duvohuu/Mechatronics_System_Design_Project/Report/chapter7.tex

\chapter{THIẾT KẾ GIẢI THUẬT ĐIỀU KHIỂN}
     \section{Lưu đồ giải thuật chung cho robot}
          \begin{figure}[H]
               \centering
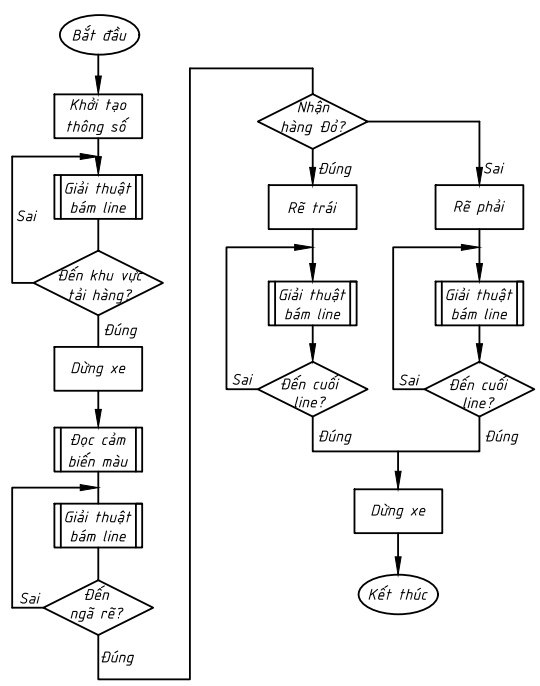
[picture p8: Report/pictures/chapter7/flow1.png]
               
               \caption{Lưu đồ giải thuật chung}
               \label{flow1}
          \end{figure}
     \section{Thiết lập sa bàn}
          \hspace*{0.6cm}Hình ảnh sa bàn đầu bài
          \begin{figure}[H]
               \centering
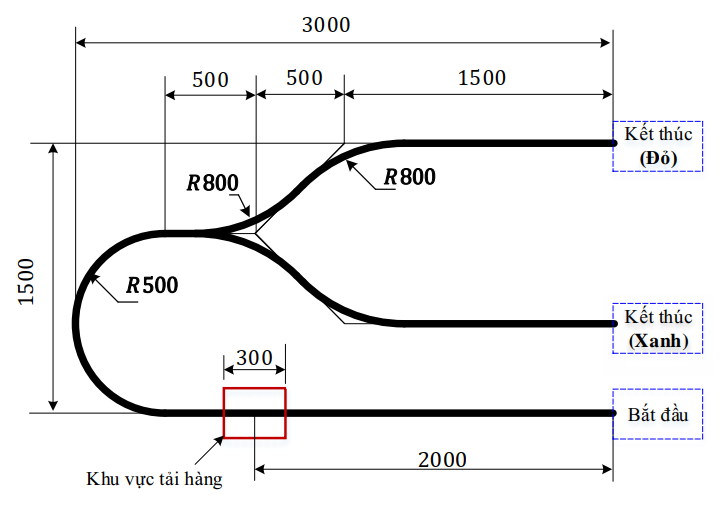
[picture p9: Report/pictures/chapter7/saban.png]
               
               \caption{Sa bàn}
               \label{race}
          \end{figure}
          Phân đoạn sa bàn
          \begin{figure}[H]
               \centering
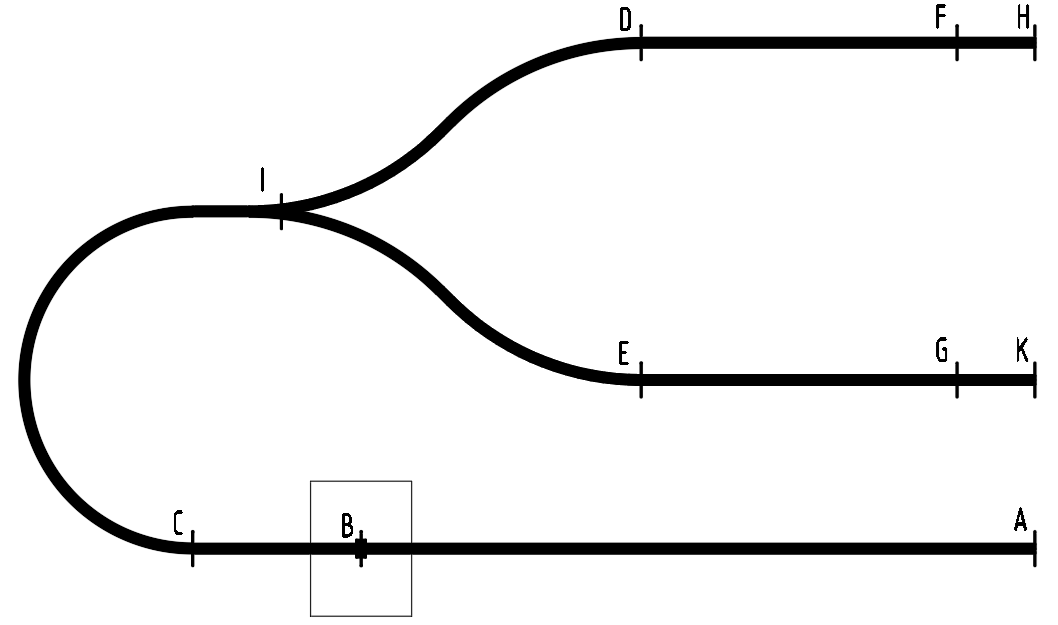
[picture p10: Report/pictures/chapter7/cut_saban.png]
               
               \caption{Phân đoạn sa bàn}
               \label{cut_race}
          \end{figure}
          Trong đó:
          \begin{itemize}
               \item $A$: điểm bắt đầu, cần đặt xe sao cho xe bắt được line đen.
               \item $B$: vị trí xe dừng để nhận hàng, được đánh dấu bằng một vạch line đen cắt
               ngang với chiều dài 50mm và chiều rộng 26mm. Với kích thước như đầu bài, vạch tải
               hàng được nhận biết khi có 3 cảm biến phát hiện được giá trị vượt ngưỡng đã đặt trước.
               \item $C$: điểm bắt đầu giảm tốc để vào cua, xe chạy tốc độ chậm hơn khi ở trên đoạn $C-D$ hoặc $C-E$.
               \item $I$: điểm rẽ hướng, Nhận biết bằng điều kiện số cảm biến nhận line đen và phân biệt với vị trí $B$ nhờ điều kiện có tải hay không.
               \item $D$ và $E$: 2 điểm kết thúc đoạn xe chạy với tốc độ chậm để đảm bảo vào cua tương ứng với 2 quỹ đạo. Sau đó xe tăng tốc chạy với tốc độ ban đầu trên các đoạn $D-F$ hoặc $E-G$.
               \item $F$ và $G$: 2 điểm xe bắt đầu giảm tốc để đảm bảo dừng lại ở vị trí cuối line, đoạn $F-H$ và $G-K$ xe chạy chậm dần đều.
               \item $H$: điểm kết thúc nếu nhận hàng màu đỏ, nhận biết điểm kết thúc khi xe đi hết đường line đen.
               \item $K$: điểm kết thúc nếu nhận hàng màu xanh, nhận biết điểm kết thúc khi xe đi hết đường line đen
          \end{itemize}
     \section{Giải thuật}
          \subsection{Giải thuật bám line}
               \hspace*{0.6cm}Giá trị analog đọc về từ 5 cảm biến dò line được tính toán bằng giải thuật nội suy
               trung bình trọng số, đưa ra được sai số $e_2$ là sai số giữa tâm cảm biến và tâm đường
               line. Đưa sai số $e_2$ là đầu vào bộ điều khiển PID hệ thống để tính toán ra vận tốc
               bánh trái và vận tốc bánh phải của động cơ. Từ vận tốc hai bánh có được đưa vào bộ
               điều khiển PID của 2 động cơ để tính toán cấp xung cho 2 động cơ tương ứng.
          \subsection{Giải thuật hoàn thành đầu bài}
               \hspace*{0.6cm}Giai đoạn 1, robot đi từ điểm bắt đầu $A$ đến điểm tải hàng $B$ bằng giải thuật bám line. Khi gặp vạch tải hàng, 3 trên 5 cảm biến dò line sẽ có giá trị vượt ngưỡng (cho thấy cả 3 cảm biến đều đã nhìn thấy line đen)
               xét cùng với trạng thái của cờ \textit{empty} (thể hiện tình trạng có tải của xe), khi đó xe dừng và cờ báo xe dừng chờ nhận tải hàng được kích hoạt.\\
               \hspace*{0.6cm}Giai đoạn 2, giai đoạn tải hàng. Khi đặt gói hàng lên xe, thì cảm biến màu sẽ đọc
               tín hiệu màu của gói hàng. Khi cảm biến đã xác nhận được màu của gói hàng là Xanh hoặc
               Đỏ, xe đợi 5s sau đó tiếp tục chạy.\\
               \hspace*{0.6cm}Giai đoạn 3, robot đi từ điểm tải hàng $B$ đến điểm rẽ hướng $I$. Bằng cách đếm xung encoder, robot nhận biết được khúc vào cua bán kính $R500$ để giảm tốc độ xuống để vào line (điểm $C$), robot sẽ đi qua đoạn cua $R500$ sau đó đi thẳng đến điểm $I$. Xe nhận biết
               được đoạn rẽ bằng số lượng cảm biến, khi 3 trên 5 cảm biến có tín hiệu và cờ báo hiệu rẽ được kích hoạt,
               xe nhận biết được sẽ rẽ sang bên đường tương ứng với màu sắc khi xác nhận tại điểm $B$.\\
               \hspace*{0.6cm}Giai đoạn 4, robot đi từ điểm rẽ hướng $I$ đến điểm kết thúc $H$ tương ứng màu Đỏ
               hoặc $K$ tương ứng màu Xanh. Trong đó trên các đoạn cua bán kính $R800$ $I-D$ và $I-E$ xe vẫn chạy với tốc độ khi vào cua $R500$. Đến điểm $D$ hoặc $E$ (vị trí các điểm xác định bằng cách đếm số xung encoder) xe bắt đầu tăng tốc trở lại vận tốc ban đầu. Đến các điểm $F$ hoặc $G$, xe bắt đầu giảm tốc để đảm bảo sai số dừng lại cuối line.
               \begin{figure}[H]
                    \centering
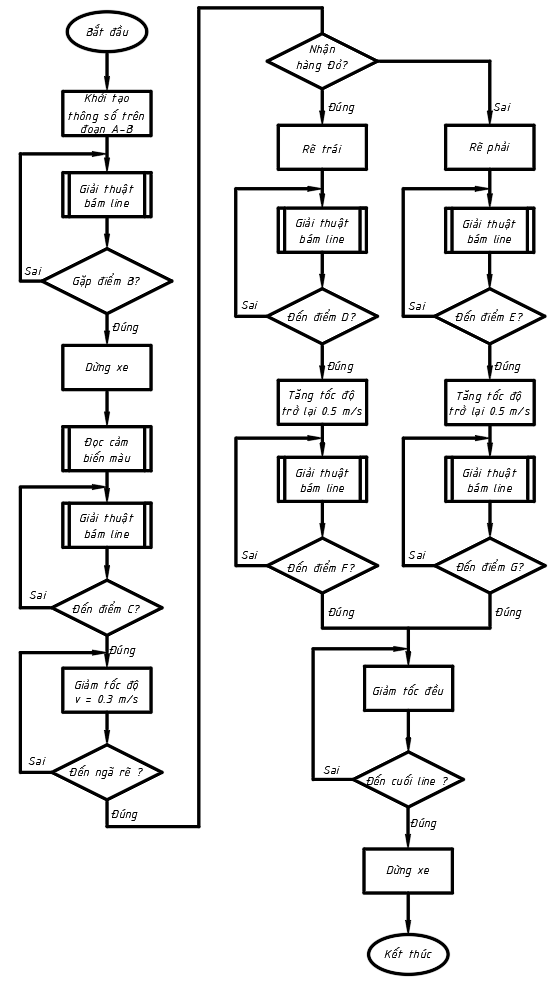
[picture p11: Report/pictures/chapter7/flow3.png]
                    
                    \caption{Lưu đồ giải thuật cụ thể trên từng đoạn sa bàn}
                    \label{flow2}
               \end{figure}
