duvohuu/Mechatronics_System_Design_Project/Report/titlepage.tex

\begin{titlepage}   
    \begin{center}
        \vspace*{-2cm} 
        \large
        \textbf{ĐẠI HỌC QUỐC GIA THÀNH PHỐ HỒ CHÍ MINH \\
        TRƯỜNG ĐẠI HỌC BÁCH KHOA\\
        KHOA CƠ KHÍ - BỘ MÔN CƠ ĐIỆN TỬ\\}
        \vspace{0.5cm}
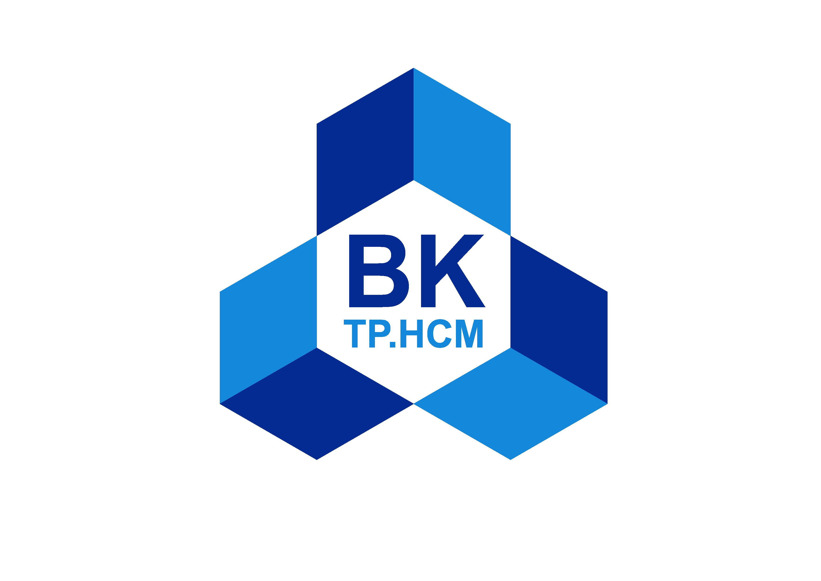
[picture p49: Report/pictures/hcmut.png]
         \\
        \rule{\linewidth}{0.5mm}\\
        \vspace{1cm}
        \large
        \textbf{ĐỒ ÁN CHUYÊN NGÀNH KỸ THUẬT CƠ ĐIỆN TỬ}\\                                                                                                                                                                                                                    
        \vspace*{0.5cm}
        \textbf{Đề số 2}\\                                                                                                                                                                                                                                                                                                                                                                                                                                             
        \vspace{0.25cm}
        \textbf{ROBOT PHÂN PHỐI HÀNG HÓA THEO MÀU SẮC}\\
        \vspace{0.5cm}
        \rule{\linewidth}{0.5mm}\\
        \vspace{0.6cm}
        \textbf{LỚP DT01 - HK 243} \\
        \vspace{0.8cm}
        \textbf{GVHD: ThS. Lương Thanh Nhật} \\[0.5cm]
        \vspace{0.5cm}
        SINH VIÊN THỰC HIỆN:\\[0.3cm]
        \begin{tabular}{|>{\centering\arraybackslash}m{1cm}|>{\centering\arraybackslash}m{7cm}|>{\centering\arraybackslash}m{5cm}|}
            \hline
            \textbf{STT} & \textbf{Họ và tên} & \textbf{MSSV} \\
            \hline
            1 & Võ Hữu Dư & 2210604 \\
            \hline
            2 & Đào Trọng Chân & 2210350 \\
            \hline
            3 & Nguyễn Trần Văn Tiên & 2210350 \\
            \hline
        \end{tabular}
    \end{center}
        
    \vfill
    \large
    \begin{center}
        TP.HCM, \today
    \end{center}
\end{titlepage}
