duvohuu/Mechatronics_System_Design_Project/Report/chapter8.tex

\chapter{MÔ PHỎNG VÀ THỰC NGHIỆM}
     \section{Mô phỏng}
          \subsection{Thông số mô phỏng robot}
               \hspace*{0.6cm}Thực hiện mô phỏng chuyển động của Robot sau khi tìm được hàm truyền của động cơ bằng cách nhúng hàm truyền động cơ thu được từ chương 5,
               bộ điều khiển tốc độ, cùng với bộ điều khiển vị trí bám line thu được từ chương 6 với các thông số như sau:
               \begin{table}[h]
                    \centering
                    \begin{tabular}{|l|c|}
                    \hline
                    \multicolumn{2}{|c|}{\textbf{Thông số hình học}} \\
                    \hline
                    Bán kính bánh xe, $r$ & 41 mm \\
                    \hline
                    Khoảng cách từ tâm dây cảm biến đến trục bánh dẫn động, $a$ & 72 mm \\
                    \hline
                    Khoảng cách dọc trục giữa tâm 2 bánh xe, $b$ & 220 mm \\
                    \hline
                    \multicolumn{2}{|c|}{\textbf{Thời gian}} \\
                    \hline
                    Thời gian lấy mẫu bộ điều khiển động cơ, $t_{\text{s}}$ & 0.01 s \\
                    \hline
                    Thời gian lấy mẫu bộ điều khiển bám line, $t_{\text{đk}}$ & 0.05 s \\
                    \hline
                    \multicolumn{2}{|c|}{\textbf{Bộ điều khiển PID}} \\
                    \hline
                    Vị trí bám line & $K_P = 0.078$; $K_D = 0.015$ \\
                    \hline
                    Động cơ phải & $K_P = 1.0852$; $K_I = 13.6563$ \\
                    \hline
                    Động cơ trái & $K_P = 1.0673$; $K_I = 13.948$ \\
                    \hline
                    \multicolumn{2}{|c|}{\textbf{Thông số động học}} \\
                    \hline
                    Vận tốc của robot, $v$ & 500 mm/s \\
                    \hline
                    Vận tốc của robot lúc vào cua, $v_{\text{r}}$ & 300 mm/s \\
                    \hline
                    Góc lệch ban đầu, $p$ & $\pi$ \\
                    \hline
                    \end{tabular}
                    \label{tab:robot_specifications}
                    \caption{Thông số đầu vào mô phỏng chuyển động của robot}
               \end{table}
          \subsection{Thực hiện mô phỏng}
               \hspace*{0.6cm}Mô phỏng bằng phần mềm MATLAB, bước đầu tiên là tạo sa bàn với các kích thước như trong đầu bài
               \begin{figure}[H]
                    \centering
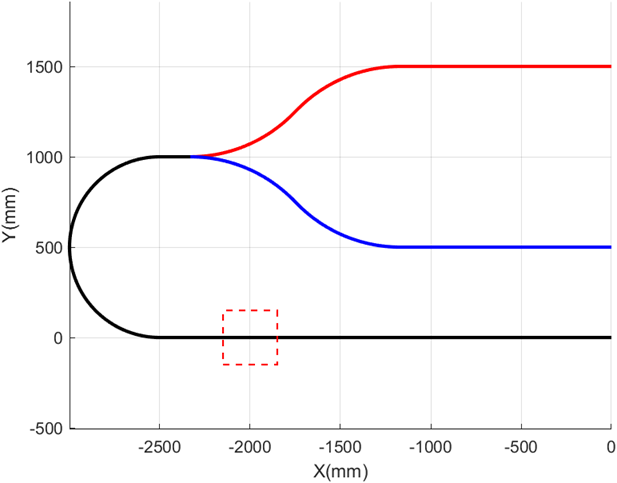
[picture p60: Report/pictures/chapter8/saban.png]
                    
                    \caption{Hình ảnh sa bàn}
                    \label{saban}
               \end{figure}
               \hspace*{0.6cm}Trong đó đường line màu đỏ và màu xanh lần lượt thể hiện nhánh rẽ khi xe nhận được khối hàng màu đỏ và xanh. Tại khu vực nhận hàng, mô phỏng quá trình đặt tải màu lên xe bằng 1 cửa sổ trong đó người dùng chọn màu sắc của khối hàng.
               \begin{figure}[H]
                    \centering
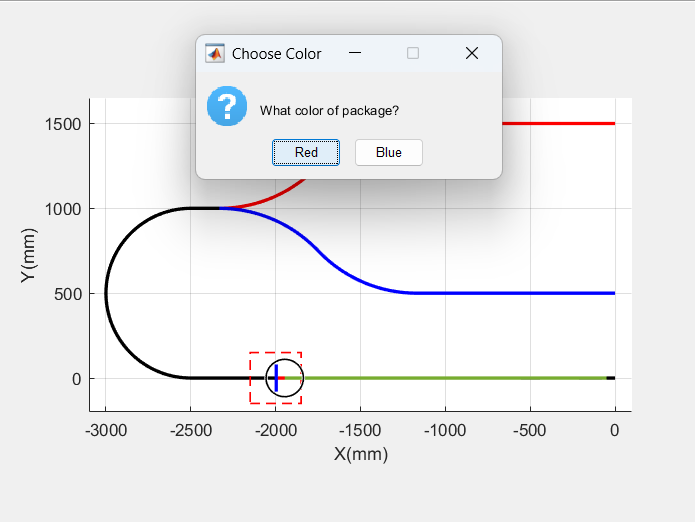
[picture p61: Report/pictures/chapter8/stop_for_package.png]
                    
                    \caption{Chọn màu sắc gói hàng}
                    \label{choose_color}
               \end{figure}
               \hspace*{0.6cm}Tùy thuộc vào màu sắc khối hàng mà sau khi gặp ngã rẽ, xe sẽ rẽ lên trên hoặc xuống dưới.
               \begin{figure}[H]
                    \centering
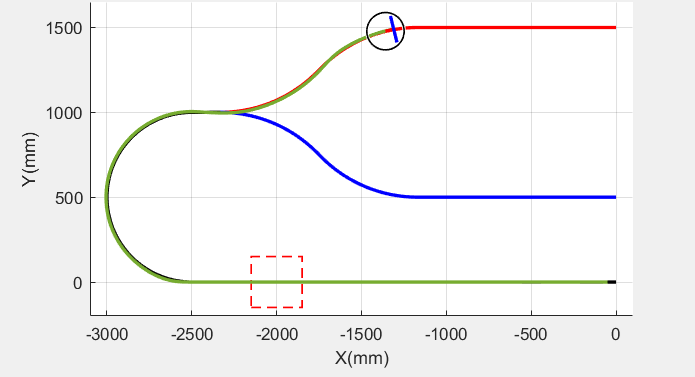
[picture p62: Report/pictures/chapter8/running.png]
                    
                    \caption{Hình ảnh xe chạy mô phỏng}
                    \label{running}
               \end{figure}     

          \subsection{Kết quả mô phỏng}
          Thực hiện mô phỏng xe chạy với vận tốc 0.3 m/s.
          \begin{itemize}
               \item \textbf{Khối hàng đỏ}
                    \begin{figure}[H]
                         \centering
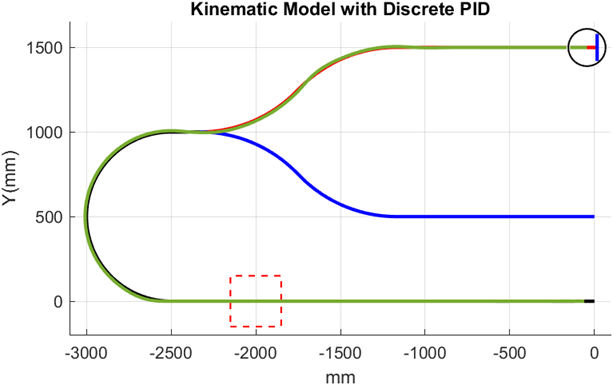
[picture p63: Report/pictures/chapter8/trajec_red.png]
                         
                         \caption{Quỹ đạo đi khi nhận khối hàng đỏ}
                         \label{tra_red}
                    \end{figure}
               \textbf{*Nhận xét:}
               \begin{itemize}
                    \item Từ hình \ref{err_red}, sai lệch trung bình giữa tâm cảm biến và tâm đường line trên toàn bộ đoạn đường là khoảng 4 mm.
                    \item Sai số bám line trên đoạn thẳng (< 6s) rất nhỏ, tuy nhiên khi xe bắt đầu vào cua thì sai số tăng dần, có 1 vị trí xe bị lệch ra khỏi line khoảng 50 mm (đối với trường hợp nhận khối hàng xanh, hình \ref{err_blue}), sau đó bám vào lại line và di chuyển tới cuối đường. 
               \end{itemize}
                    \begin{figure}[H]
                         \centering
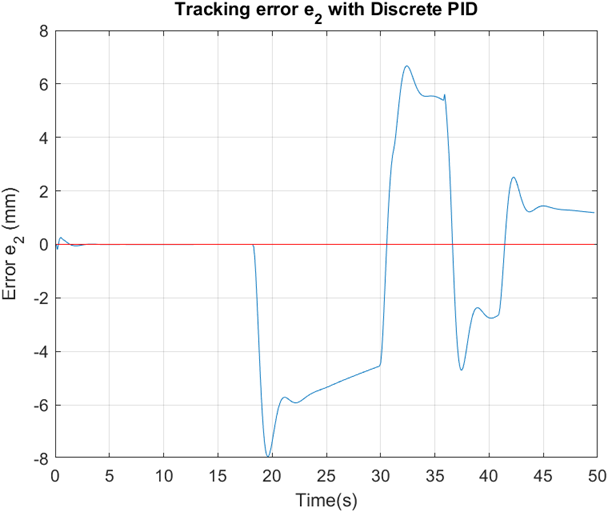
[picture p64: Report/pictures/chapter8/err_red.png]
                         
                         \caption{Sai số bám line e2 khi nhận khối hàng đỏ}
                         \label{err_red}
                    \end{figure}
               \item \textbf{Khối hàng xanh}
          \end{itemize}
               
          \subsection{Khối hàng xanh}
               \begin{figure}[H]
                    \centering
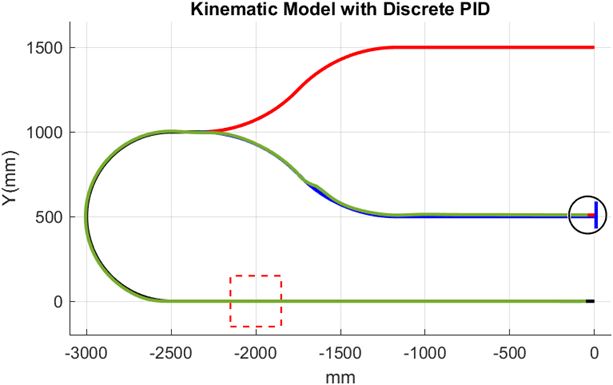
[picture p65: Report/pictures/chapter8/trajec_blue.png]
                    
                    \caption{Quỹ đạo đi khi nhận khối hàng xanh}
                    \label{tra_blue}
               \end{figure}
               \begin{figure}[H]
                    \centering
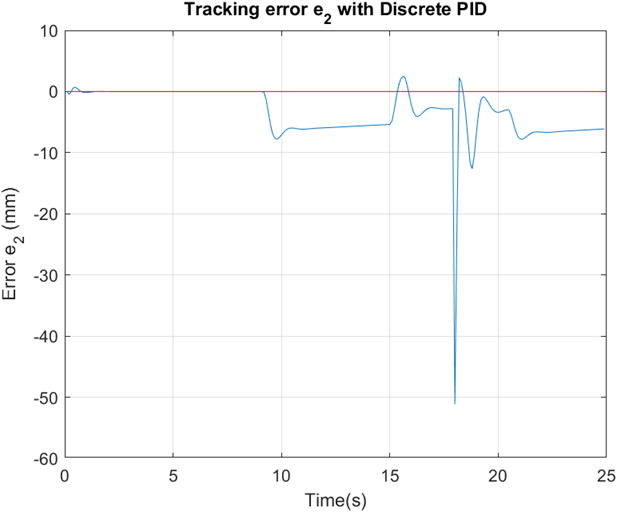
[picture p66: Report/pictures/chapter8/err_blue.png]
                    
                    \caption{Lỗi quỹ đạo e2 khi nhận khối hàng xanh}
                    \label{err_blue}
               \end{figure}
     \section{Thực nghiệm}
          \subsection{Thực nghiệm tổng quan}
               \begin{figure}[H]
                    \centering
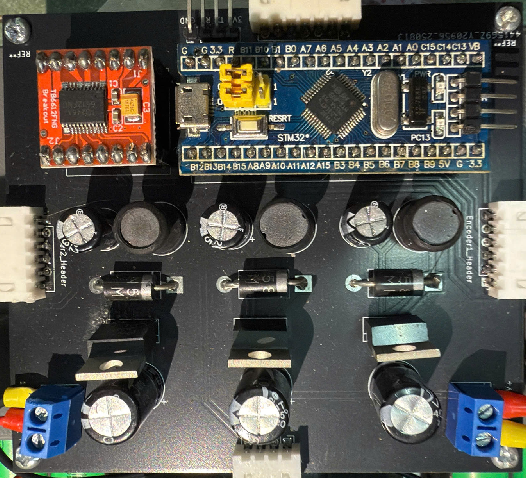
[picture p67: Report/pictures/chapter8/PCB.png]
                    
                    \caption{Mạch PCB điều khiển}
                    \label{PCB}
               \end{figure}
               \begin{figure}[H]
                    \centering
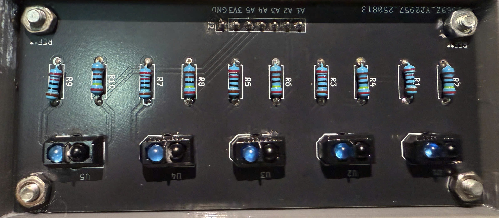
[picture p68: Report/pictures/chapter8/sensor.png]
                    
                    \caption{Mạch cảm biến dò line}
                    \label{line_sensor}
               \end{figure}
               \begin{figure}[H]
                    \centering
                    \begin{minipage}{0.42\textwidth}
                         \centering
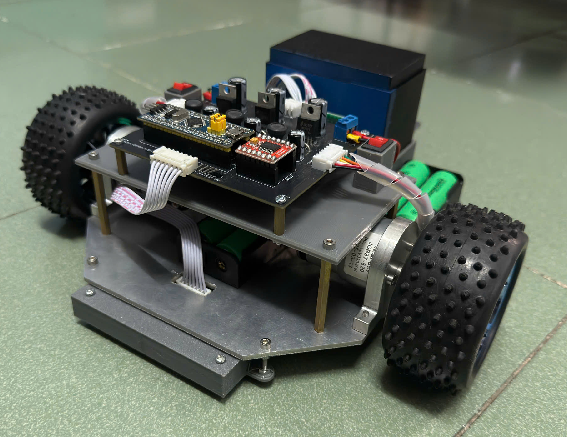
[picture p69: Report/pictures/chapter8/xe_full1.png]
                         
                    \end{minipage}\hfill
                    \begin{minipage}{0.42\textwidth}
                         \centering
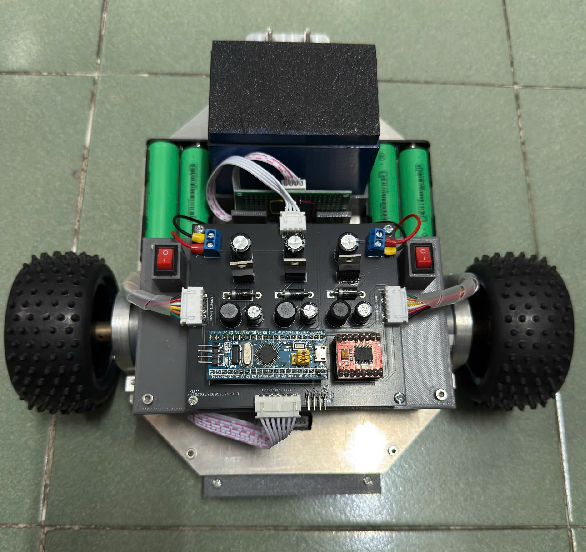
[picture p70: Report/pictures/chapter8/xe_full2.png]
                         
                    \end{minipage}
                    \caption{Robot dò line sau khi đã lắp hoàn chỉnh}
                    \label{xe_full}
               \end{figure}
               \begin{figure}[H]
                    \centering
                    \begin{minipage}{0.5\textwidth}
                         \centering
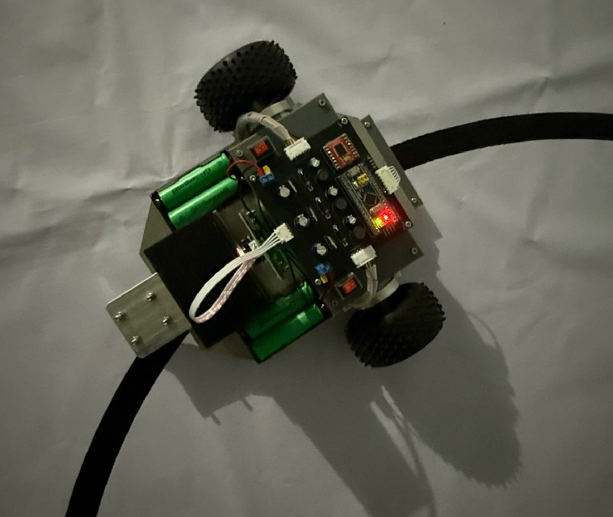
[picture p71: Report/pictures/chapter8/turn.png]
                         
                         \caption{Xe rẽ vào đoạn cua R500}
                         \label{fig:chapter8:1.2 - 1}
                    \end{minipage}\hfill
                    \begin{minipage}{0.42\textwidth}
                         \centering
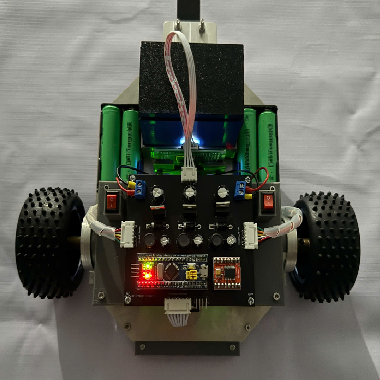
[picture p72: Report/pictures/chapter8/end.png]
                         
                         \caption{Xe dừng cuối line}
                         \label{fig:chapter8:1.2 - 4}
                    \end{minipage}
                    \vspace{0.5cm}

                    \begin{minipage}{0.5\textwidth}
                         \centering
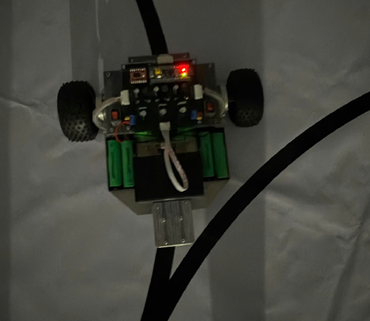
[picture p73: Report/pictures/chapter8/turn_left.png]
                         
                         \caption{Xe rẽ trái khi nhận khối hàng màu đỏ}
                         \label{fig:chapter8:1.2 - 2}
                    \end{minipage}\hfill
                    \begin{minipage}{0.42\textwidth}
                         \centering
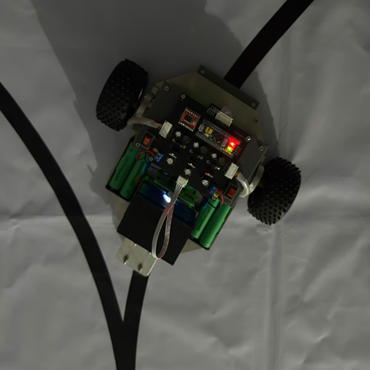
[picture p74: Report/pictures/chapter8/turn_right.png]
                         
                         \caption{Xe rẽ phải khi nhận hàng màu xanh}
                         \label{fig:chapter8:1.2 - 3}
                    \end{minipage}
               \end{figure}
          \hspace*{0.6cm}Robot được chạy thử nghiệm trên sa bàn in với kích thước giống kích thước của đầu bài. Khu vực tải hàng được đại diện bằng 1 đường line đen dài 50mm, rộng 26mm và cách vị trí xuất phát đầu line 2000mm. Robot được thử nghiệm chạy với các tốc độ khác nhau $0.3 \,\mathrm{m/s}, \,  0.5 \,\mathrm{m/s}, \, 0.8 \,\mathrm{m/s}$.\\
               \hspace*{0.6cm}\textbf{Nhận xét:}
               \begin{itemize}
                    \item Với vận tốc $v = 0.3 \,\mathrm{m/s}$, xe di chuyển chậm, khá ổn định. Thời gian hoàn thành khoảng 28 đến 30 giây.
                    \item Với vận tốc $v = 0.5 \,\mathrm{m/s}$, xe di chuyển trên đường thẳng ổn định. Thời gian hoàn thành khoảng 18 đến 22 giây.
                    \item Với vận tốc $v = 0.8 \,\mathrm{m/s}$, xe di chuyển nhanh, đoạn line thẳng xe đi rất ổn định nếu lúc đầu đặt tâm dãy cảm biến của xe ở chính giữa line, nếu đặt hơi lệch có thể dẫn đến xe hơi lắc trong quá trình chạy. Thời gian hoàn thành khoảng 10 đến 15 giây.
               \end{itemize}
          \subsection{Thực nghiệm kiểm tra sai số bám line}
               \hspace*{0.6cm}Tiến hành thu thập dữ liệu bằng cách tính toán và lưu giá trị sai số $e_2$ vào 1 mảng sau mỗi khoảng thời gian lấy mẫu của bộ điều khiển bám line ($t_{\text{đk}} = 0.05 \,\mathrm{s}$).\\
               \hspace*{0.6cm}Kết thúc mỗi đoạn hành trình, lấy dữ liệu về máy tính bằng cách kết nối với vi điều khiển STM32 trên xe thông qua ST-Link, sử dụng phần mềm STM32 ST-Link Utility. Nhập địa chỉ của mảng lưu các giá trị $e_2$ vào ô \textit{Address}, nhập số lượng byte cần đọc vào ô \textit{Size}, độ rộng dữ liệu vào ô \textit{Data Width}. Sau đó \textit{Save} ở định dạng \textit{.bin}.
               \begin{figure}[H]
                    \centering
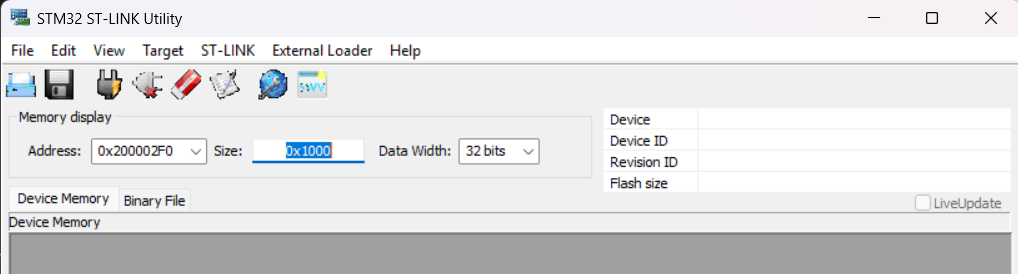
[picture p75: Report/pictures/chapter8/utility.png]
                    
                    \caption{Giao diện STM32 ST-Link Utility}
                    \label{utility}
               \end{figure}
               \hspace*{0.6cm}Sau đó viết đoạn code Python (Phụ lục \ref{lst:e2_plot}) để thực hiện đọc file data đuôi \textit{.bin} và plot đồ thị. Kết quả thu được sai số $e_2$ đọc được thực tế thể hiện trong hình \ref{actual_e2_blue} và \ref{actual_e2_red}.\\
               \hspace*{0.6cm}\textbf{Nhận xét:}
               \begin{itemize}
                    \item Trong cả 2 trường hợp, với sai số cho phép tính từ tâm cảm biến đến mép line không quá 3mm, nghĩa là sai số e2 tính từ tâm cảm biến đến tâm đường line nằm trong khoảng $-16 \leq e_2 \leq 16 \,\mathrm{mm}$, thì kết quả đo được từ cảm biến cho thấy sai số nằm trong khoảng cho phép
                    \item Với cách thực nghiệm dựa trên sai số $e_2$ được đo và tính toán từ cảm biến, là các giá trị ước lượng, có thể dùng làm feedback cho bộ điều khiển nhưng chưa đủ để làm căn cứ đánh giá sai số bám line thực tế. Do 
                    đó trong quá trình thực nghiệm, nhóm thực hiện đánh dấu vị trí tâm trên nắp che dãy cảm biến và theo dõi vị trí tương đối so với 2 mép line. Trong quá trình quan sát robot chạy, nhận thấy vị trí tâm luôn nằm trong đường line đen, do đó kết luận sai số bám line có thể được đảm bảo.
               \end{itemize}
               \begin{figure}[H]
                    \centering
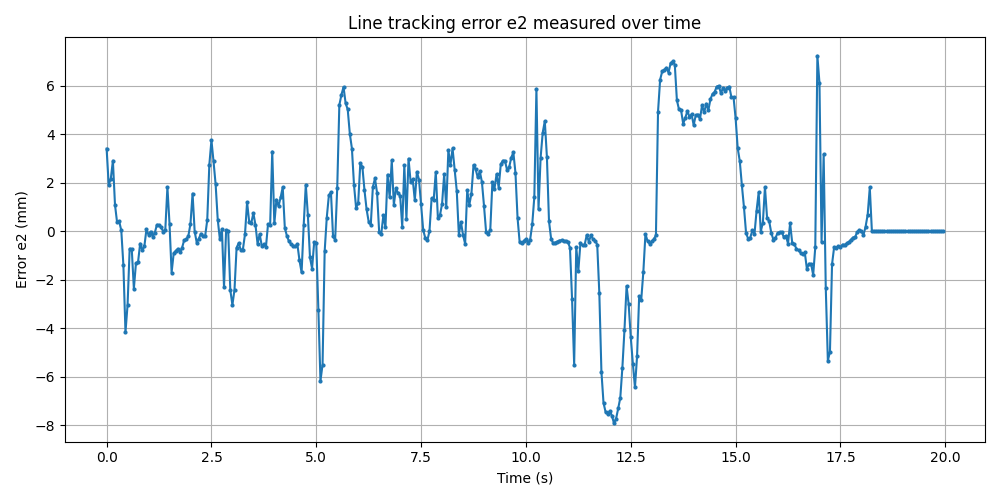
[picture p76: Report/pictures/chapter8/actual_e2_blue.png]
                    
                    \caption{Sai số $e_2$ đo được khi nhận hàng xanh}
                    \label{actual_e2_blue}
               \end{figure}
               \begin{figure}[H]
                    \centering
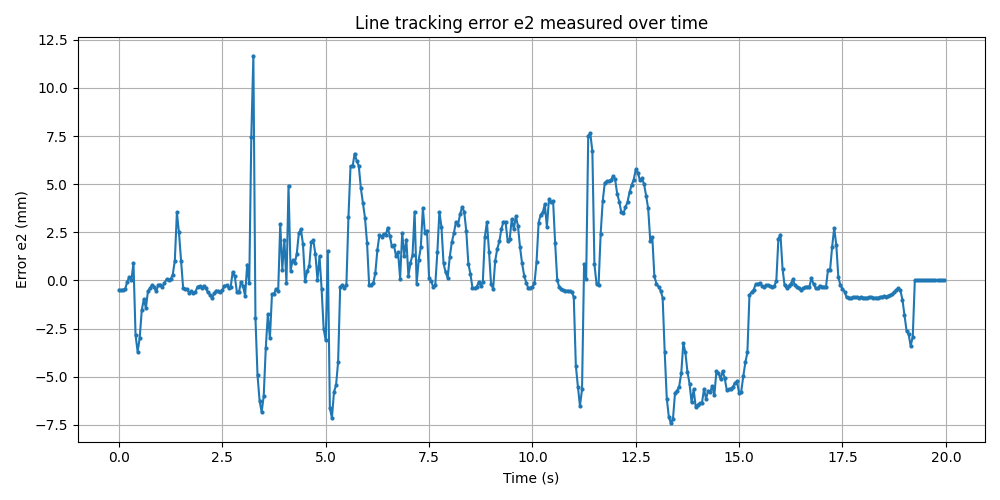
[picture p77: Report/pictures/chapter8/actual_e2_red.png]
                    
                    \caption{Sai số $e_2$ đo được khi nhận hàng đỏ}
                    \label{actual_e2_red}
               \end{figure}
          \subsection{Đánh giá}
               \begin{itemize}
                    \item Với nhiệm vụ bám line, xe thực hiện bám line khá tốt cả trên đoạn line thẳng và đoạn vào cua.
                    \item Tại khu vực nhận hàng, xe dừng để chờ nhận tải và chờ nhận đúng màu sắc trong đề bài (xanh hoặc đỏ) mới tiếp tục hoàn thành quãng đường còn lại.
                    \item Về bộ điều khiển PID vận tốc động cơ 2 bánh, kết quả các hệ số của bộ điều khiển tìm được nhờ công cụ Tuning của MATLAB khá sát với các hệ số khi triển khai code thực tế vì đều sử dụng bộ điều khiển PID dạng rời rạc, chứng tỏ bước lấy mẫu động cơ, tìm hàm truyền và sử dụng MATLAB để tìm các hệ số cho bộ điều khiển là quan trọng, giúp cho việc triển khai thực tế dễ dàng hơn. 
               \end{itemize}
          \subsection{Kết luận}
               \hspace*{0.6cm}Qua đề tài thiết kế xe dò line phân phối hàng hóa theo màu sắc, nhóm đã thực hiện được các mục tiêu sau:
               \begin{itemize}
                    \item Tìm hiểu tổng quan về các mô hình AGVs nói chung và xe dò line nói riêng.
                    \item Biết được cách thực hiện dự án theo hướng thiết kế hệ thống cơ điện tử.
                    \item Học được các bước thiết kế hệ cơ khí, lắp ráp các bộ phận của robot.
                    \item Học được cách tính toán, chọn các linh kiện điện tử và thiết kế mạch in PCB.
                    \item Hoàn thành bộ hồ sơ thiết kế thỏa mãn các yêu cầu của đồ án trong thời gian quy định.
               \end{itemize}
