duvohuu/Mechatronics_System_Design_Project/Report/main.tex

\documentclass[12pt,a4paper]{report}
\input{library}
\addbibresource{references.bib} 

%Header
\fancyhead{} % clear all header fields
\fancyhead[L]{
    \begin{tabular}{rl}
        \begin{picture}(15, 15)(0,0)
            \put(-15, -15){}
        \end{picture}&
        \begin{tabular}{l}
            \textbf{\bf \ttfamily Trường Đại Học Bách Khoa - ĐHQG TP.HCM}\\
            \textbf{\bf \ttfamily Đồ án chuyên ngành Cơ điện tử}\\
        \end{tabular} 	
    \end{tabular}
}
\fancyhead[R]{CHƯƠNG \thechapter}
% Footer
\fancyfoot[C]{\thepage} % số trang giữa
\renewcommand{\headrulewidth}{0.3pt}
\renewcommand{\footrulewidth}{0.3pt}

\begin{document}
    \include{titlepage}
    \pagenumbering{roman}
    \setcounter{page}{1}

    \tableofcontents  
    \listoftables
    \listoffigures
    \newpage

    \pagenumbering{arabic}
    \setcounter{page}{1}

    \normalsize
    \include{chapter1}
    \include{chapter2}
    \include{chapter3}
    \include{chapter4}
    \include{chapter5}
    \include{chapter6}
    \include{chapter7}
    \include{chapter8}
    \setcounter{section}{0}
    \renewcommand{\thesection}{\Alph{section}}
    \include{appendix}
    \nocite{*}
    \printbibliography[title={TÀI LIỆU THAM KHẢO}, heading=bibintoc]
\end{document}
