duvohuu/Mechatronics_System_Design_Project/Report/pictures/chapter1/chapter1_pic11a_pinto.png

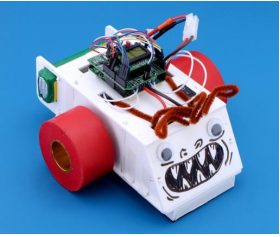
Report/pictures/chapter1/chapter1_pic11a_pinto.png
