duvohuu/Mechatronics_System_Design_Project/Report/pictures/chapter1/chapter1_pic12a_newbie.png

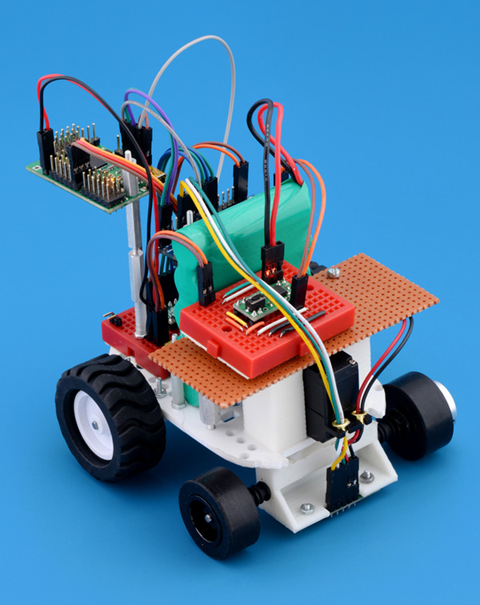
Report/pictures/chapter1/chapter1_pic12a_newbie.png
