duvohuu/Mechatronics_System_Design_Project/Report/pictures/chapter1/chapter1_pic16b_photoresistor.png

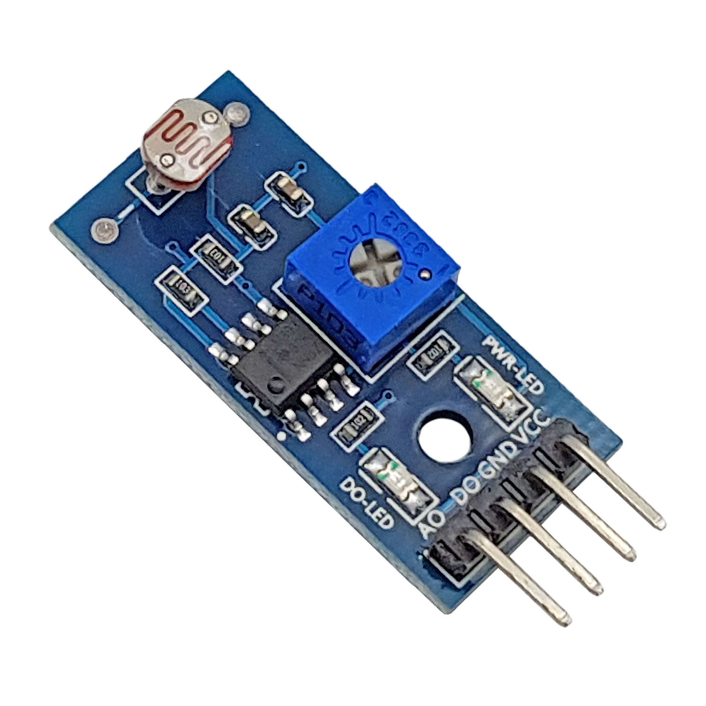
Report/pictures/chapter1/chapter1_pic16b_photoresistor.png
