duvohuu/Mechatronics_System_Design_Project/Report/pictures/chapter1/chapter1_pic_5b.png

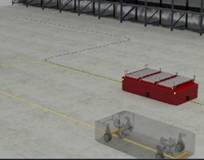
Report/pictures/chapter1/chapter1_pic_5b.png
