duvohuu/Mechatronics_System_Design_Project/Report/pictures/chapter1/chapter1_pic_7a.png

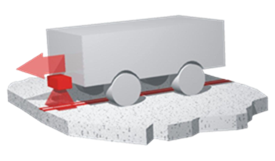
Report/pictures/chapter1/chapter1_pic_7a.png
