duvohuu/Mechatronics_System_Design_Project/Report/pictures/chapter2/chapter2_pic_14.png

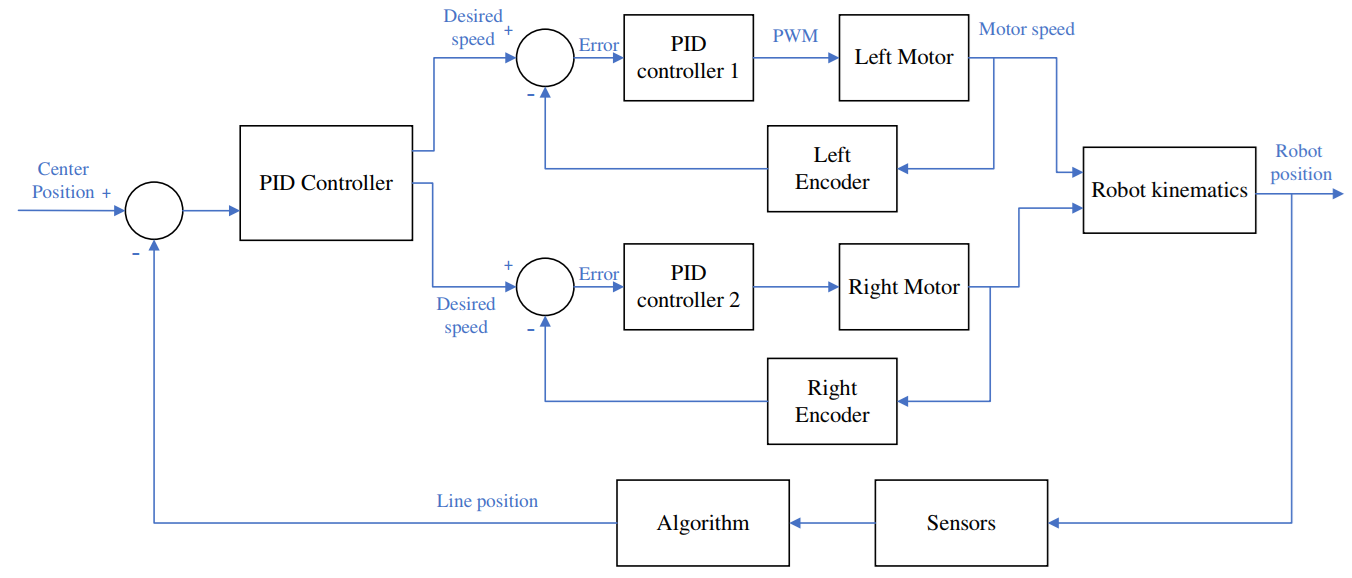
Report/pictures/chapter2/chapter2_pic_14.png
