duvohuu/Mechatronics_System_Design_Project/Report/pictures/chapter7/flow2.png

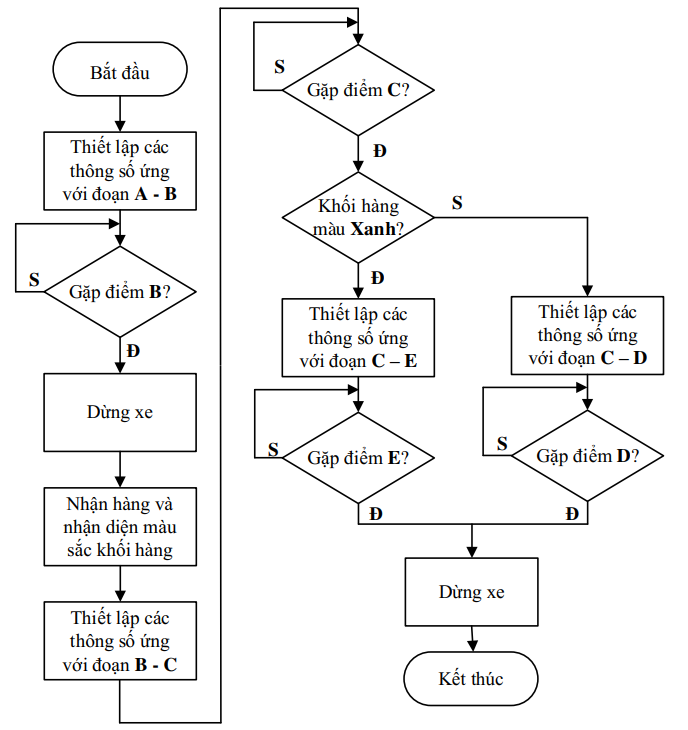
Report/pictures/chapter7/flow2.png
