duvohuu/Mechatronics_System_Design_Project/Report/pictures/chapter7/line_blue.png

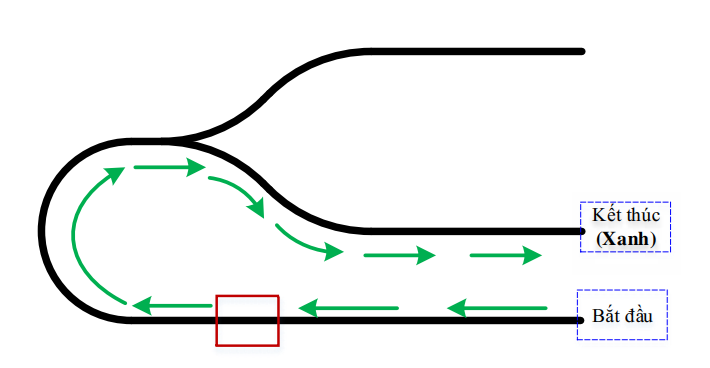
Report/pictures/chapter7/line_blue.png
