duvohuu/Mechatronics_System_Design_Project/Report/pictures/chapter8/thucte1.png

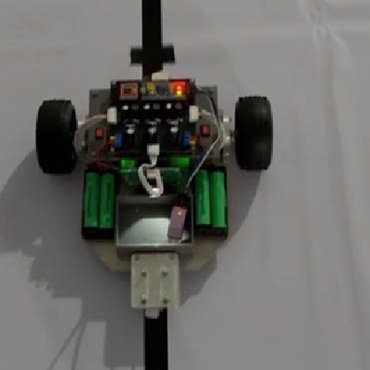
Report/pictures/chapter8/thucte1.png
