duvohuu/Mechatronics_System_Design_Project/Report/pictures/chapter8/thucte2.png

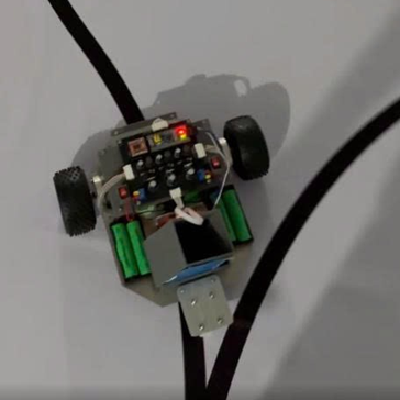
Report/pictures/chapter8/thucte2.png
