duvohuu/Mechatronics_System_Design_Project/Code/0.3/Full_Code_Ver1/Core/Src/main.c

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
/* Includes ------------------------------------------------------------------*/
#include "main.h"

/* USER CODE BEGIN Includes */
#include <stdlib.h>
#include <stdint.h>
#include <stdio.h>
#include <stdbool.h>
#include <math.h>

#include "params.h"
#include "color_sensor.h"
#include "get_e2_error.h"
#include "pid_line.h"
#include "pid_motor.h"
#include "others.h"

/* USER CODE END Includes */

/* USER CODE BEGIN PD */
#define T_SAMP 0.01f
#define PULSE_2_RPM (60.0f) / (11.0f * 30.0f * 4.0f * T_SAMP)
#define PI 3.1415926
/* USER CODE END PD */

ADC_HandleTypeDef hadc1;
DMA_HandleTypeDef hdma_adc1;

I2C_HandleTypeDef hi2c1;

TIM_HandleTypeDef htim1;
TIM_HandleTypeDef htim2;
TIM_HandleTypeDef htim3;
TIM_HandleTypeDef htim4;

UART_HandleTypeDef huart3;

/* USER CODE BEGIN PV */

// Define the buffer for storing ADC readout values
#define DATA_LENGTH 5
uint16_t data_buffer[DATA_LENGTH];
float A0 = 0, A1 = 0, A2 = 0, A3 = 0, A4 = 0;
float sumADCvalues = 0;

// Variables for estimating the Motors' speeds
int16_t position_motor_1 = 0, old_position_motor_1 = 0;
int pulse_motor_1 = 0;

int16_t position_motor_2 = 0, old_position_motor_2 = 0;
int pulse_motor_2 = 0;

// Variables for error line
volatile float prev_e2 = 0, curr_e2 = 0;
volatile float e2_buffer = 0;

// Variables count for PID line following controller
volatile uint8_t time_ratio = 0;

// Variables for computing PI Speed Controller
volatile float w_right = 0, w_left = 0;
volatile float curr_w_right = 0, curr_w_left = 0;

volatile float e1R = 0, e0R = 0;
volatile float v1R = 0, v0R = 0;

volatile float e1L = 0, e0L = 0;
volatile float v1L = 0, v0L = 0;

volatile int16_t u0R = 0, u1R = 0;
volatile int16_t u0L = 0, u1L = 0;

volatile uint8_t actR = 0, actL = 0;

// Variables for PID line following controller
volatile float delta_w = 0;		// Output of PID line following controller (angular of robot)
volatile float pre_Dpart = 0;	// D part in PD controller

// Variables for decelaration phase
volatile float minus_e2 = 0;
volatile uint16_t count = 0;
volatile uint16_t count_decelartion_1 = 0;
volatile uint16_t count_decelartion_2 = 0;

// Variables for encoder count
volatile float real_nr = 0, real_nl = 0;
volatile float real_wr = 0, real_wl = 0;
volatile float real_uM = 0;
volatile float distance = 0;
volatile float total_distance = 0;
float distance_calib = 0;
volatile float displacement = 0;
volatile float v_ref = 0.0f;


// Variables for auto find line when outline and not to endline
volatile bool recovery_mode = false;
volatile bool outline_right = false;
volatile bool outline_left = false;
volatile uint16_t count_outline_right = 0;
volatile uint16_t count_outline_left = 0;
volatile bool turn_right_phase1 = false;
volatile bool turn_right_phase2 = false;
volatile bool turn_left_phase1 = false;
volatile bool turn_left_phase2 = false;
volatile uint16_t count_turn_right_phase2 = 0;
volatile uint16_t count_turn_left_phase2 = 0;


//volatile uint16_t avoidance_count = 0;
//volatile uint16_t avoidance_count_phase_3 = 0;

/* USER CODE END PV */

void SystemClock_Config(void);
static void MX_GPIO_Init(void);
static void MX_DMA_Init(void);
static void MX_ADC1_Init(void);
static void MX_TIM1_Init(void);
static void MX_TIM3_Init(void);
static void MX_TIM4_Init(void);
static void MX_TIM2_Init(void);
static void MX_I2C1_Init(void);
static void MX_USART3_UART_Init(void);
/* USER CODE BEGIN 0 */

void HAL_TIM_PeriodElapsedCallback(TIM_HandleTypeDef *htim)
{
	if (htim->Instance == TIM2 && stop == false)
	{
		if (time_ratio == 5)
		{
			if (is_steering == false && recovery_mode == false)
			{
					/* Calculate error e2 */
				prev_e2 = curr_e2;
				curr_e2 = calculate_sensor_value_aftercalib(data_buffer);
				minus_e2 = curr_e2 - prev_e2;

				if (empty == false){
					displacement = total_distance - distance_calib;
				}

//				if (displacement <= 250 || (displacement >= 1450 && displacement <= 2900)){
//					if (minus_e2 >= 8.0 || curr_e2 >= 17.0){
//						recovery_mode = true;
//						outline_right = true;
//						turn_right_phase1 = true;
//					}
//					if (minus_e2 <= -8.0 || curr_e2 <= -17.0){
//						recovery_mode = true;
//						outline_left = true;
//						turn_left_phase1 = true;
//					}
//				}
				if (displacement <= 2900 && (curr_e2 >= 20.0)){
					recovery_mode = true;
					outline_right = true;
					turn_right_phase1 = true;
				}

				if (displacement <= 2900 && (curr_e2 <= -20.0)){
					recovery_mode = true;
					outline_left = true;
					turn_left_phase1 = true;
				}


				if (displacement >= 250 && displacement <= 2250){
					calculate_PID_trackingline(V_REF_TURN, curr_e2, prev_e2, &delta_w, &pre_Dpart, &w_right, &w_left, &displacement);
				}
				else if (is_delivery_area == true && count_decelartion_1 != 13){
					v_ref = V_REF - count_decelartion_1 * 41.65f;
					calculate_PID_trackingline(v_ref, curr_e2, prev_e2, &delta_w, &pre_Dpart, &w_right, &w_left, &displacement);
					count_decelartion_1++;
				}
				else if (displacement >= 2930 && count_decelartion_2 != 21){
					v_ref = V_REF - count_decelartion_2 * (V_REF - 2.0) / 20.0f;
					calculate_PID_trackingline(v_ref, curr_e2, prev_e2, &delta_w, &pre_Dpart, &w_right, &w_left, &displacement);
					count_decelartion_2++;
				}
				else {
					calculate_PID_trackingline(V_REF, curr_e2, prev_e2, &delta_w, &pre_Dpart, &w_right, &w_left, &displacement);
				}


//					/* Calculate output of PID line following controller */
//				calculate_PID_trackingline(curr_e2, prev_e2, &delta_w, &pre_Dpart, &w_right, &w_left, &total_distance, &red_package, &blue_package);

			}

			e2_buffer = calculate_sensor_value_aftercalib(data_buffer);
					/* Check if robot get to turn and turn when count != 10 */
			if (is_steering == true && red_package == true && count != 10 && has_steered == false)
			{
				/* for V_REF = 0.5 m/s */
				w_right = (V_REF_TURN / (D_WHEEL / 2.0f)) + 2.0f;
				w_left = (V_REF_TURN / (D_WHEEL / 2.0f)) - 2.0f;
				/* for V_REF = 0.5 m/s */
//				w_right = 15.0f;
//				w_left = 6.5f;
				count++;
			}


			if (is_steering == true && blue_package == true && count != 10 && has_steered == false)
			{
				/* for V_REF = 0.5 m/s */
				w_right = (V_REF_TURN / (D_WHEEL / 2.0f)) - 2.0f;
				w_left = (V_REF_TURN / (D_WHEEL / 2.0f)) + 2.0f;
				/* for V_REF = 0.5 m/s */
//				w_right = 6.5f;
//				w_left = 15.0f;
				count++;
			}

			if (count == 10)
			{
				has_steered = true;
				is_steering = false;
			}
			time_ratio = 0;
		}

		if (recovery_mode == true){
			if (outline_right == true){
				if (data_buffer[1] > 2000 && turn_right_phase1 == true){
					turn_right_phase1 = false;
					turn_right_phase2 = true;
				}
				if (turn_right_phase1 == true) {
					w_right = (V_REF_TURN / (D_WHEEL / 2.0f)) + 3.5f;
					w_left = (V_REF_TURN / (D_WHEEL / 2.0f)) - 1.5f;
				}
				if (turn_right_phase2 == true){
					w_right = 0.0f;
					w_left = (V_REF_TURN / (D_WHEEL / 2.0f)) - 2.0f;
					count_turn_right_phase2++;
				}
				if (count_turn_right_phase2 >= 40 && (data_buffer[2] > 2800 && abs_float(e2_buffer) < 8.0)){
					recovery_mode = false;
					outline_right = false;
					outline = false;
					turn_right_phase1 = false;
					turn_right_phase2 = false;
					count_turn_right_phase2 = 0;
				}
			}
			if (outline_left == true){
				if (data_buffer[3] > 2000 && turn_left_phase1 == true){
					turn_left_phase1 = false;
					turn_left_phase2 = true;
				}
				if (turn_left_phase1 == true) {
					w_left = (V_REF_TURN / (D_WHEEL / 2.0f)) + 3.5f;
					w_right = (V_REF_TURN / (D_WHEEL / 2.0f)) - 1.5f;
				}
				if (turn_left_phase2 == true){
					w_left = 0.0f;
					w_right = (V_REF_TURN / (D_WHEEL / 2.0f)) - 2.0f;
					count_turn_left_phase2++;
				}
				if (count_turn_left_phase2 >= 40 && (data_buffer[2] > 2800 && abs_float(e2_buffer) < 8.0)){
					recovery_mode = false;
					outline_left = false;
					outline = false;
					turn_left_phase1 = false;
					turn_left_phase2 = false;
					count_turn_left_phase2 = 0;
				}
			}
		}
	}

	//old code for turn right

//		if (data_buffer[1] > 2000 && turn_right_phase1 == true){
//			turn_right_phase1 = false;
//			turn_right_phase2 = true;
//		}
//
//
//		if (recovery_mode == true && outline_right == true){
//			if (turn_right_phase1 == true) {
//				w_right = (V_REF_TURN / (D_WHEEL / 2.0f)) + 3.5f;
//				w_left = (V_REF_TURN / (D_WHEEL / 2.0f)) - 1.5f;
//			}
//			if (turn_right_phase2 == true){
//				w_right = 0.0f;
//				w_left = (V_REF_TURN / (D_WHEEL / 2.0f)) - 2.0f;
//				count_turn_right_phase2++;
//			}
//			if (count_turn_right_phase2 == 65 || (data_buffer[2] > 3100 && abs_float(e2_buffer) < 8.0)){
//				recovery_mode = false;
//				outline_right = false;
//				outline = false;
//				turn_right_phase1 = false;
//				turn_right_phase2 = false;
//				count_turn_right_phase2 = 0;
//			}
//		}

	// old code for turn left

//		if (data_buffer[3] > 2000 && turn_left_phase1 == true){
//			turn_left_phase1 = false;
//			turn_left_phase2 = true;
//		}
//
//
//		if (recovery_mode == true && outline_left == true){
//			if (turn_left_phase1 == true) {
//				w_left = (V_REF_TURN / (D_WHEEL / 2.0f)) + 3.5f;
//				w_right = (V_REF_TURN / (D_WHEEL / 2.0f)) - 1.5f;
//			}
//			if (turn_left_phase2 == true){
//				w_left = 0.0f;
//				w_right = (V_REF_TURN / (D_WHEEL / 2.0f)) - 2.0f;
//				count_turn_left_phase2++;
//			}
//			if ((count_turn_left_phase2 == 65 && (data_buffer[1] > 2500 || data_buffer[2] > 2500 || data_buffer[3] > 2500)) || (data_buffer[2] > 3100 && abs_float(e2_buffer) < 8.0)){
//				recovery_mode = false;
//				outline_left = false;
//				outline = false;
//				turn_left_phase1 = false;
//				turn_left_phase2 = false;
//				count_turn_left_phase2 = 0;
//			}
//		}

		/////////////////////////////////////////////////////////
		/// Process the position values of 2 Motors' Encoders ///
		/////////////////////////////////////////////////////////

		position_motor_1 = 65535 - __HAL_TIM_GET_COUNTER(&htim1);
		pulse_motor_1 = (int16_t)(position_motor_1 - old_position_motor_1);
		old_position_motor_1 = position_motor_1;
		curr_w_right = pulse_motor_1 * PULSE_2_RPM * RPM_2_RADS;		// (rad/s)
			// Encoder count for right wheel
		real_nr = (float)(pulse_motor_1 * 60)/(330 * MOTOR_SAMP_TIME);
		real_wr = curr_w_right;

		position_motor_2 = __HAL_TIM_GET_COUNTER(&htim3);
		pulse_motor_2 = (int16_t)(position_motor_2 - old_position_motor_2);
		old_position_motor_2 = position_motor_2;
		curr_w_left = pulse_motor_2 * PULSE_2_RPM * RPM_2_RADS;		// (rad/s)
			// Encoder count for right wheel
		real_nl = (float)(pulse_motor_2 * 60)/(330 * MOTOR_SAMP_TIME);
		real_wl = curr_w_left;

			// Calculate total distance

		real_uM = (real_wr + real_wl) * (D_WHEEL / 4.0f);
		distance = real_uM * MOTOR_SAMP_TIME;
		total_distance += distance / (1.5f);




		////////////////////////////////////
		/// PID Calculation for 2 Motors ///
		////////////////////////////////////

		update_Motor_Error(&e1R, &e0R,
						   &e1L, &e0L,
						   &u0R, &u1R,
						   &u0L, &u1L,
						   w_right, w_left,
						   curr_w_right, curr_w_left,
						   &actR, &actL);



		////////////////////////
		/// Actuate 2 Motors ///
		////////////////////////

		__HAL_TIM_SET_COMPARE(&htim4, TIM_CHANNEL_3, (uint16_t)actR);
		if (u0R <= 0)
		{
			CCW_Motor_R();
		} else {
			CW_Motor_R();
		}

		__HAL_TIM_SET_COMPARE(&htim4, TIM_CHANNEL_4, (uint16_t)actL);
		if (u0L <= 0)
		{
			CW_Motor_L();
		} else {
			CCW_Motor_L();
		}
		time_ratio ++;
}



/* USER CODE END 0 */

/**
  * @brief  The application entry point.
  * @retval int
  */
int main(void)
{

  /* MCU Configuration--------------------------------------------------------*/

  /* Reset of all peripherals, Initializes the Flash interface and the Systick. */
  HAL_Init();

  /* Configure the system clock */
  SystemClock_Config();

  /* Initialize all configured peripherals */
  MX_GPIO_Init();
  MX_DMA_Init();
  MX_ADC1_Init();
  MX_TIM1_Init();
  MX_TIM3_Init();
  MX_TIM4_Init();
  MX_TIM2_Init();
  MX_I2C1_Init();
  MX_USART3_UART_Init();
  /* USER CODE BEGIN 2 */
  HAL_TIM_Base_Start_IT(&htim2);
  HAL_TIM_PWM_Start(&htim4, TIM_CHANNEL_3);
  HAL_TIM_PWM_Start(&htim4, TIM_CHANNEL_4);
  HAL_TIM_Encoder_Start(&htim1, TIM_CHANNEL_ALL);
  HAL_TIM_Encoder_Start(&htim3, TIM_CHANNEL_ALL);
  HAL_ADC_Start_DMA(&hadc1, (uint32_t*)data_buffer, DATA_LENGTH);
  /* USER CODE END 2 */

  /* Infinite loop */
  /* USER CODE BEGIN WHILE */
  while (1)
  {
	  check_to_turn(data_buffer, &displacement);
//	  stop_for_package(data_buffer, &w_right, &w_left);
	  stop_for_package_new(data_buffer, &v_ref, &w_right, &w_left);
	  stop_no_line(data_buffer, &w_right, &w_left);
	  if (has_stop_for_package == true){
		  distance_calib = total_distance;
		  detect_color();
	  }
	  restart(data_buffer);
	  if (recovery_mode == true && has_stop_for_package == false){
		  stop = false;
	  }
//	  detect_color();
    /* USER CODE END WHILE */

    /* USER CODE BEGIN 3 */
  }
  /* USER CODE END 3 */
}

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
