duvohuu/Mechatronics_System_Design_Project/Code/0.3/Full_Code_Ver1/Full_Code_Ver1.ioc

Mcu.UserName=STM32F103C8Tx
PA1.GPIO_Label=AN1
PA1.Signal=ADCx_IN1
PA13.Signal=SYS_JTMS-SWDIO
PA14.Signal=SYS_JTCK-SWCLK
PA2.GPIO_Label=AN2
PA2.Signal=ADCx_IN2
PA3.GPIO_Label=AN3
PA3.Signal=ADCx_IN3
PA4.GPIO_Label=AN4
PA4.Signal=ADCx_IN4
PA5.GPIO_Label=AN5
PA5.Signal=ADCx_IN5
PA6.GPIO_Label=EN2_Data1
PA6.Signal=S_TIM3_CH1
PA7.GPIO_Label=EN2_Data2
PA7.Signal=S_TIM3_CH2
PA8.GPIO_Label=EN1_Data1
PA8.Signal=S_TIM1_CH1
PA9.GPIO_Label=EN1_Data2
PA9.Signal=S_TIM1_CH2
PB10.GPIO_Label=RX
PB10.Signal=USART3_TX
PB11.GPIO_Label=TX
PB11.Signal=USART3_RX
PB12.GPIO_Label=BI2
PB12.Signal=GPIO_Output
PB13.GPIO_Label=BI1
PB13.Signal=GPIO_Output
PB14.GPIO_Label=AI2
PB14.Signal=GPIO_Output
PB15.GPIO_Label=AI1
PB15.Signal=GPIO_Output
PB6.GPIO_Label=SCL
PB6.Signal=I2C1_SCL
PB7.GPIO_Label=SDA
PB7.Signal=I2C1_SDA
PB8.GPIO_Label=PWM_A
PB8.Signal=S_TIM4_CH3
PB9.GPIO_Label=PWM_B
PB9.Signal=S_TIM4_CH4
PC13-TAMPER-RTC.GPIO_Label=LED
PC13-TAMPER-RTC.Signal=GPIO_Output
PD0-OSC_IN.Signal=RCC_OSC_IN
PD1-OSC_OUT.Signal=RCC_OSC_OUT
