duvohuu/Mechatronics_System_Design_Project/(commit log)

2025-07-09 chuong1: tới phần so sánh cảm biến odf line
2025-07-10 còn phần bộ điều khiển và đầu bài
2025-07-12 Chương 2 - Lựa chọn nguyên lý cơ khí
2025-07-17 lựa chọn phương án điều khiển
2025-09-22 report_23_9: Còn chương 9 Kết quả thực nghiệm
2025-09-23 Xong chương 3, Còn chương 9: Kết quả
