duvohuu/Mechatronics_System_Design_Project/(notices)

Notices in the files:
Code/0.8/Full_Code_Ver1/Core/Inc/main.h:
Copyright (c) 2025 STMicroelectronics.
All rights reserved.
This software is licensed under terms that can be found in the LICENSE file
